glennji/yutani-terminal/render_detail.png

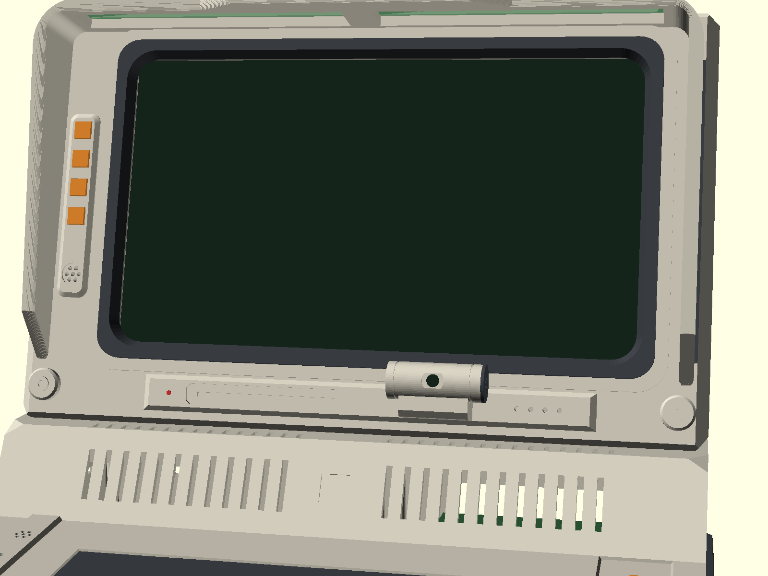
render_detail.png
