glennji/yutani-terminal/render_front.png

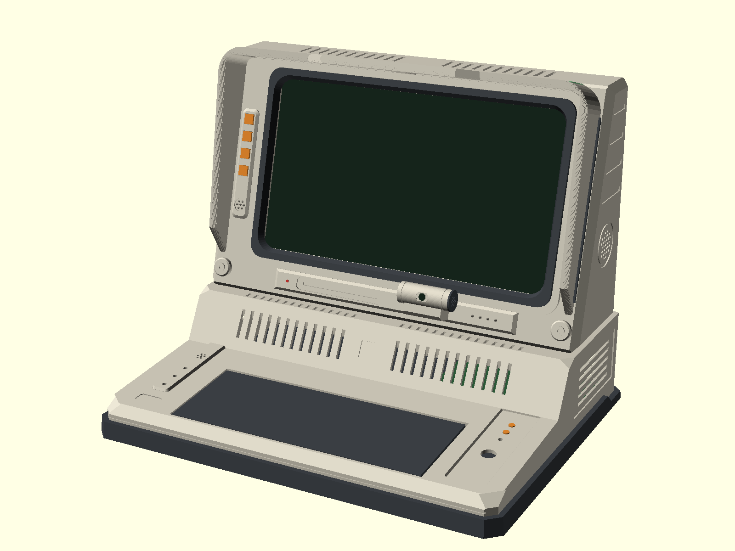
render_front.png
