glennji/yutani-terminal/render_rear.png

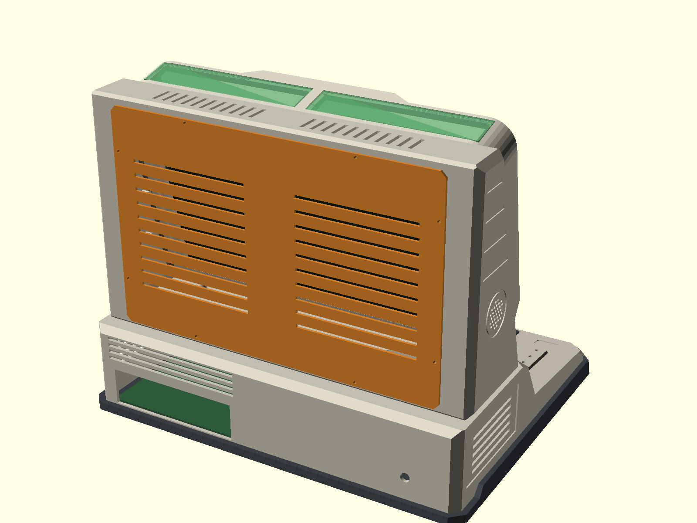
render_rear.png
