glennji/yutani-terminal/render_side.png

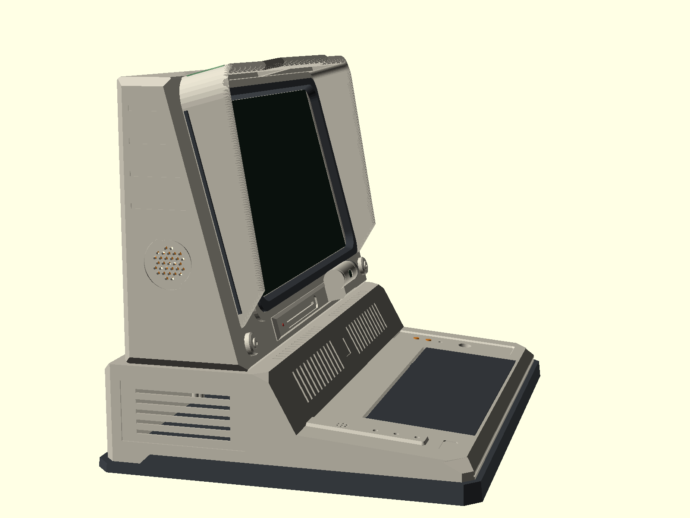
render_side.png
