glennji/yutani-terminal/3mf/pod_BR.3mf

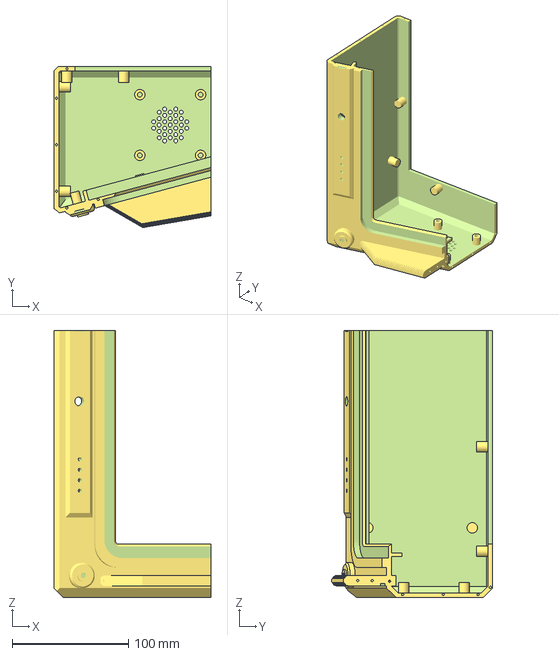
[picture p7: CAD file, 2026-10-31]
3mf/pod_BR.3mf
135.0 x 138.9 x 230.0 mm
