glennji/yutani-terminal/terminal.stl

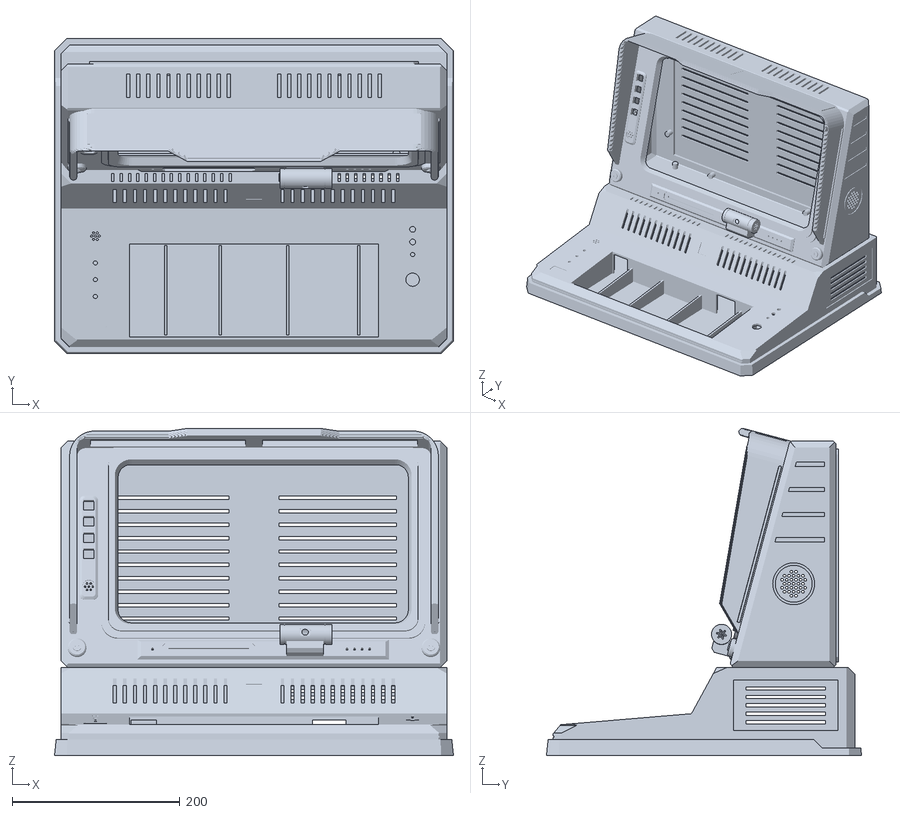
[picture p8: CAD file, 2026-10-26]
terminal.stl
476.0 x 376.0 x 390.4
