glennji/yutani-terminal/3mf/hatch_R.3mf

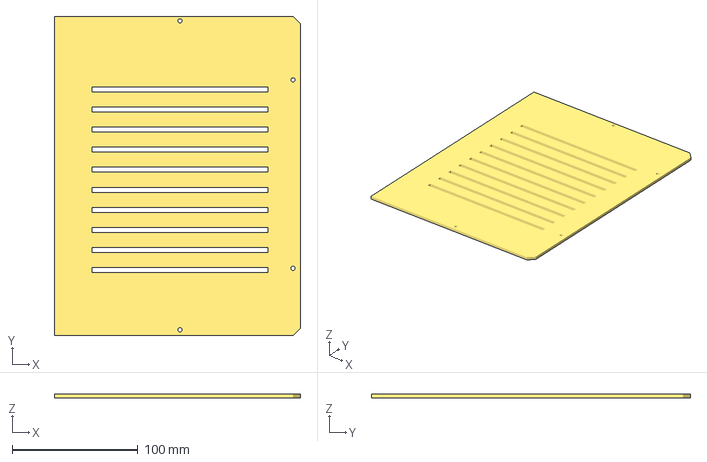
[picture p10: CAD file, 2026-10-31]
3mf/hatch_R.3mf
196.0 x 254.0 x 3.00 mm
