glennji/yutani-terminal/3mf/pod_TR.3mf

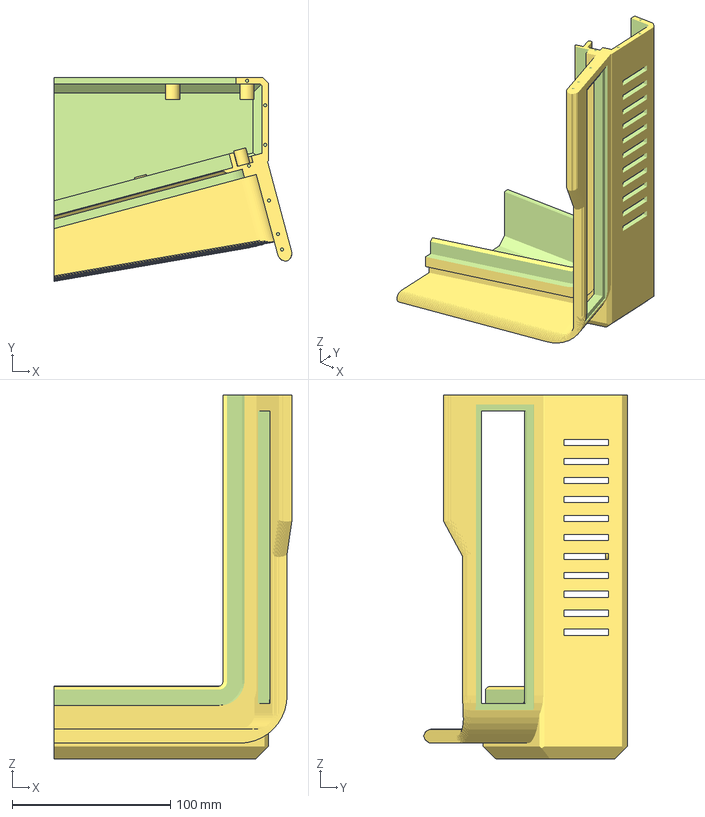
[picture p11: CAD file, 2026-10-31]
3mf/pod_TR.3mf
150.4 x 128.8 x 230.0 mm
