glennji/yutani-terminal/3mf/cam_body.3mf

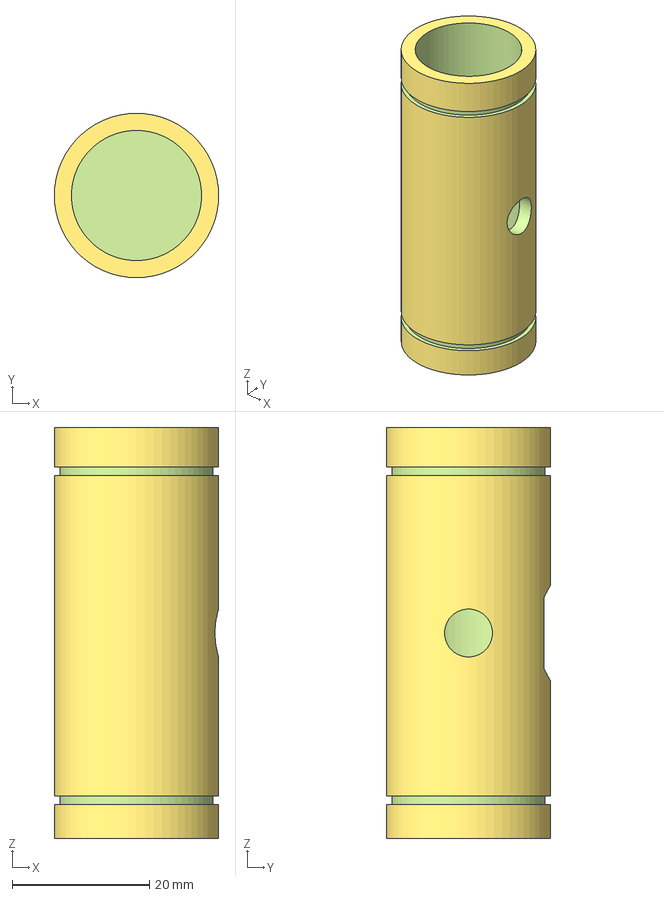
[picture p12: CAD file, 2026-10-31]
3mf/cam_body.3mf
24.0 x 24.0 x 60.0 mm
