glennji/yutani-terminal/3mf/clamp_tab.3mf

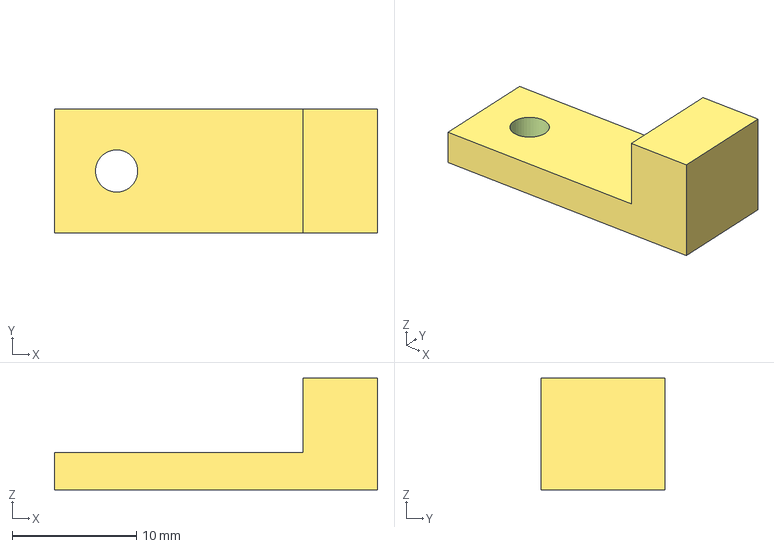
[picture p13: CAD file, 2026-10-31]
3mf/clamp_tab.3mf
26.0 x 10.0 x 9.00 mm
