glennji/yutani-terminal/3mf/base_FR.3mf

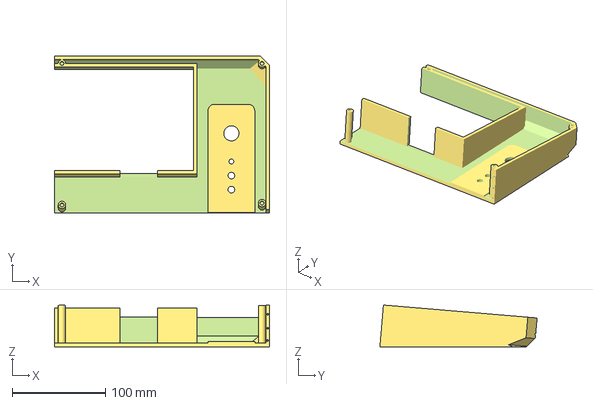
[picture p14: CAD file, 2026-10-31]
3mf/base_FR.3mf
230.0 x 168.2 x 44.8 mm
