glennji/yutani-terminal/3mf/plate_FL.3mf

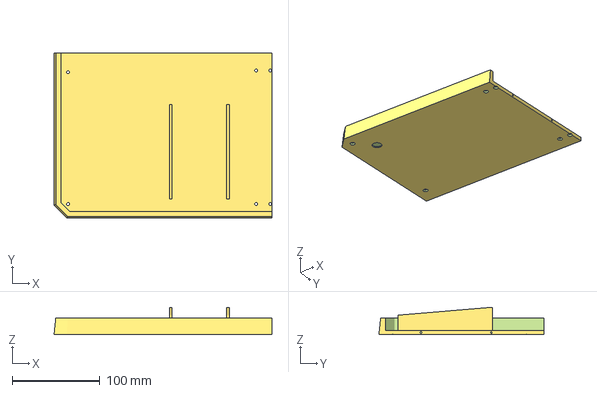
[picture p15: CAD file, 2026-10-31]
3mf/plate_FL.3mf
248.0 x 188.0 x 31.3 mm
