glennji/yutani-terminal/3mf/plate_RL.3mf

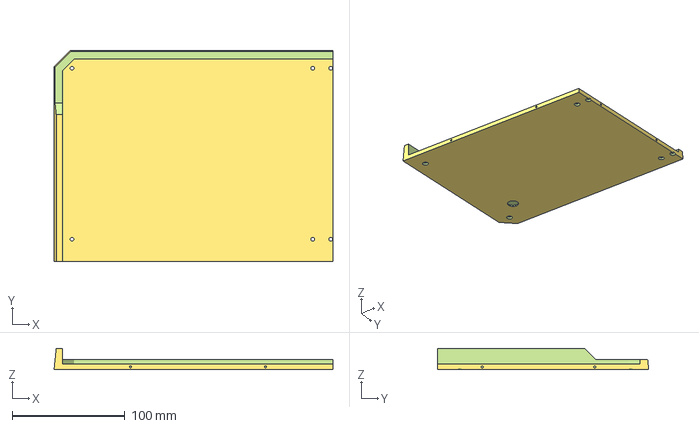
[picture p16: CAD file, 2026-10-31]
3mf/plate_RL.3mf
248.0 x 188.0 x 19.0 mm
