glennji/yutani-terminal/3mf/base_RL.3mf

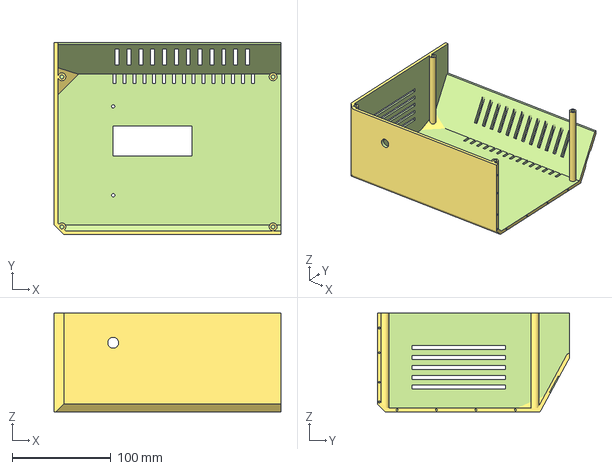
[picture p17: CAD file, 2026-10-31]
3mf/base_RL.3mf
230.0 x 195.0 x 100.0 mm
