glennji/yutani-terminal/3mf/plate_RR.3mf

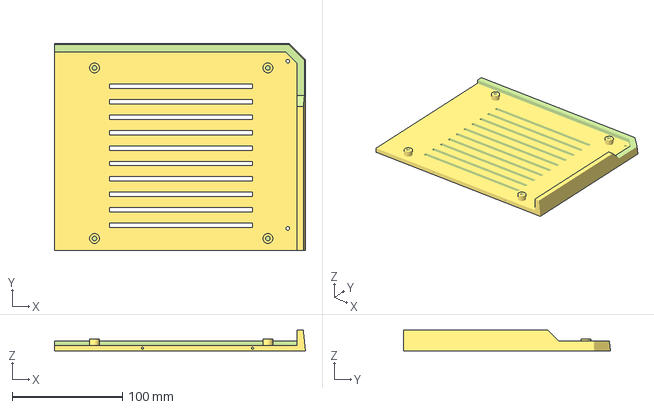
[picture p18: CAD file, 2026-10-31]
3mf/plate_RR.3mf
228.0 x 188.0 x 19.0 mm
