glennji/yutani-terminal/3mf/gasket_L.3mf

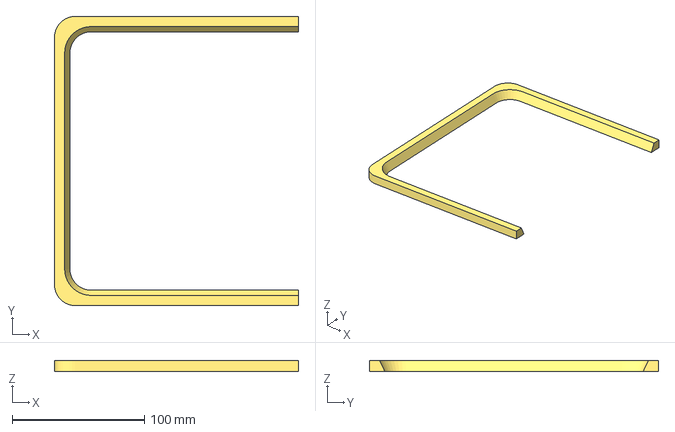
[picture p19: CAD file, 2026-10-31]
3mf/gasket_L.3mf
184.8 x 219.0 x 8.50 mm
