glennji/yutani-terminal/3mf/trim_strip.3mf

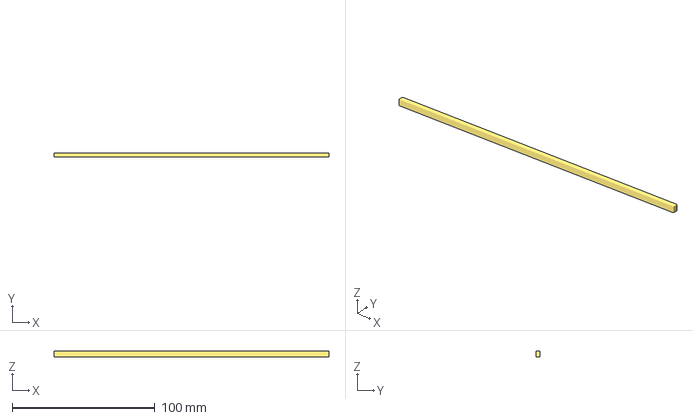
[picture p20: CAD file, 2026-10-31]
3mf/trim_strip.3mf
192.6 x 3.10 x 4.00 mm
