glennji/yutani-terminal/3mf/base_RR.3mf

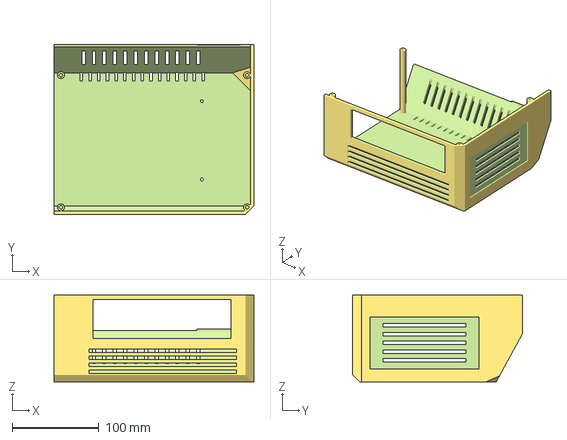
[picture p21: CAD file, 2026-10-31]
3mf/base_RR.3mf
230.0 x 195.0 x 100.0 mm
