glennji/yutani-terminal/3mf/island_L.3mf

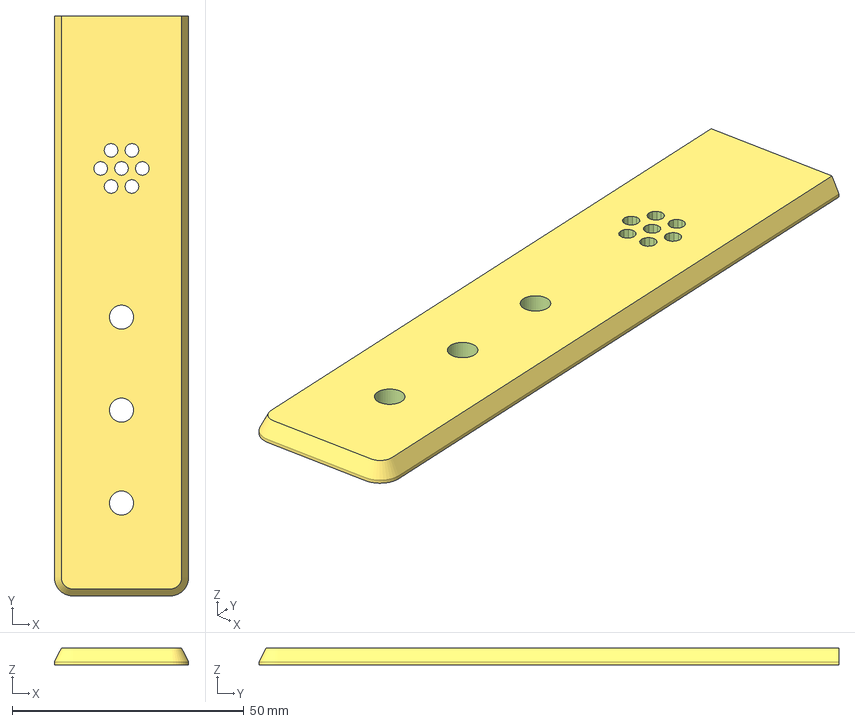
[picture p22: CAD file, 2026-10-31]
3mf/island_L.3mf
29.0 x 125.2 x 3.60 mm
