glennji/yutani-terminal/3mf/cam_cradle.3mf

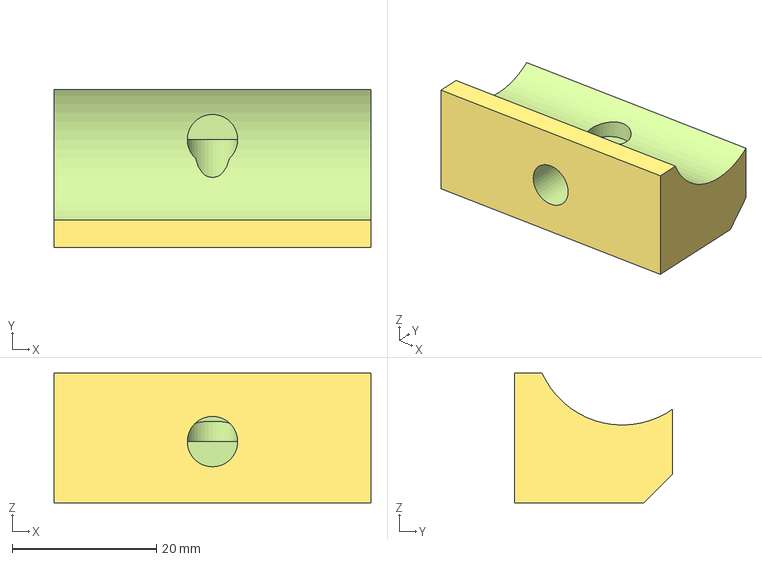
[picture p23: CAD file, 2026-10-31]
3mf/cam_cradle.3mf
44.0 x 22.0 x 18.0 mm
