glennji/yutani-terminal/3mf/visor.3mf

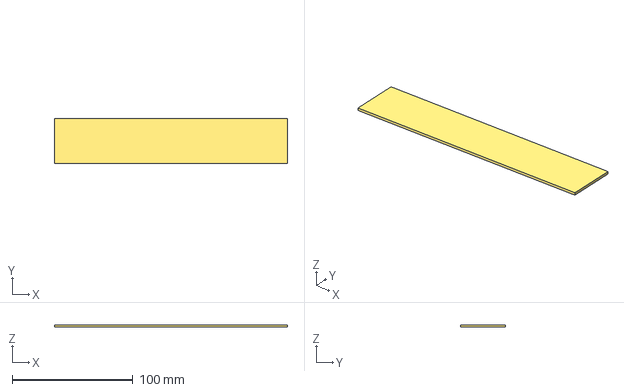
[picture p24: CAD file, 2026-10-31]
3mf/visor.3mf
192.6 x 37.6 x 2.00 mm
