glennji/yutani-terminal/3mf/plate_FR.3mf

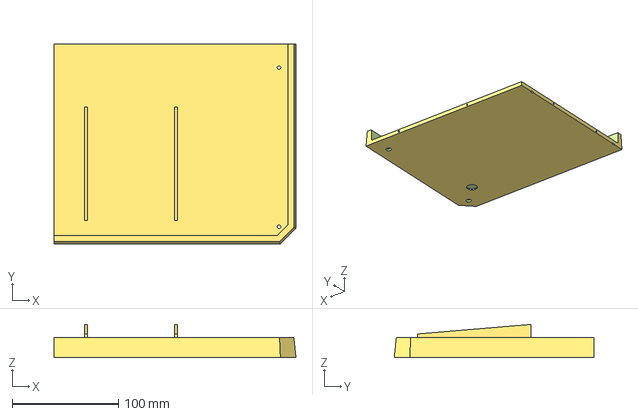
[picture p25: CAD file, 2026-10-31]
3mf/plate_FR.3mf
228.0 x 188.0 x 31.3 mm
