glennji/yutani-terminal/3mf/cam_cap.3mf

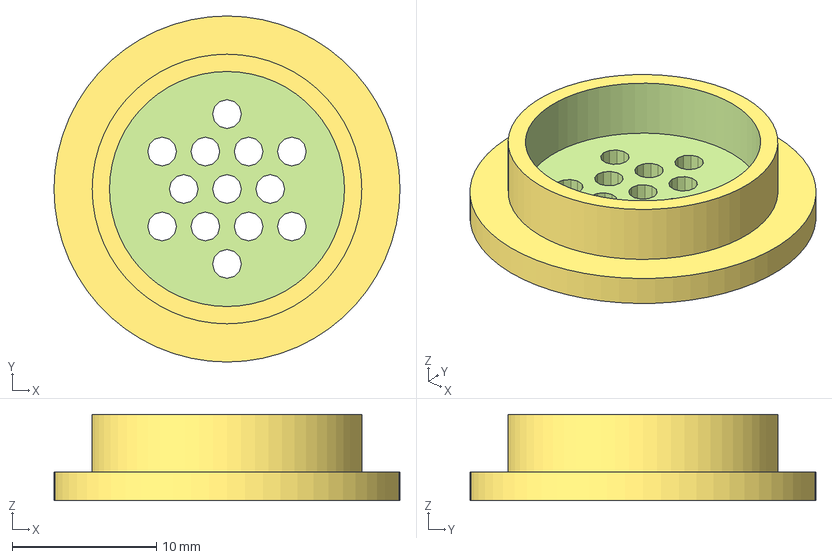
[picture p26: CAD file, 2026-10-31]
3mf/cam_cap.3mf
24.0 x 24.0 x 6.00 mm
