glennji/yutani-terminal/(list of files, cad)

Other CAD files:
3mf/base_FL.3mf
3mf/hatch_L.3mf
3mf/pod_BL.3mf
3mf/gasket_R.3mf
stl/base_FL.stl
stl/base_FR.stl
stl/base_RL.stl
stl/base_RR.stl
stl/cam_body.stl
stl/cam_cap.stl
stl/cam_cradle.stl
stl/clamp_tab.stl
stl/gasket_L.stl
stl/gasket_R.stl
stl/hatch_L.stl
stl/hatch_R.stl
stl/island_L.stl
stl/plate_FL.stl
stl/plate_FR.stl
stl/plate_RL.stl
stl/plate_RR.stl
stl/pod_BL.stl
stl/pod_BR.stl
stl/pod_TL.stl
stl/pod_TR.stl
stl/trim_strip.stl
stl/visor.stl
