glennji/yutani-terminal/(commit log)

2026-10-26 shaping it up
    [base_FL.3mf, base_FL.stl, base_FR.3mf, base_FR.stl, base_RL.3mf, base_RL.stl, base_RR.3mf, base_RR.stl]
2026-10-31 Re-export 3mf/ with island_L; fix webcam tube depth in README
    3mf/ was missing island_L.3mf and predated the current island
    geometry. Regenerated all 23 parts with ./export.sh 3mf (manifold
    backend, no warnings). README now quotes cam_len (60 mm) and the
    57.5 mm bore depth from cam_body(). No geometry parameters changed.
    [base_FL.3mf, base_FR.3mf, base_RL.3mf, base_RR.3mf, cam_body.3mf, cam_cap.3mf, cam_cradle.3mf, clamp_tab.3mf]
2026-10-31 Re-export stale stl/ parts (island_L, base_FL, base_FR)
    The committed STLs for these three parts predate the current island
    size (islands width 29). island_L was 22 x 115 mm and is now 29 x 125 mm,
    and the front bases are re-cut with the matching pocket. Nothing in
    terminal.scad changed. The other 20 STLs re-exported geometrically
    identical (same bbox and volume), so they are left untouched.
    [base_FL.stl, base_FR.stl, island_L.stl]
